jamesrklau/bead-chain-blind-motor/cad/case/case_lid.stl

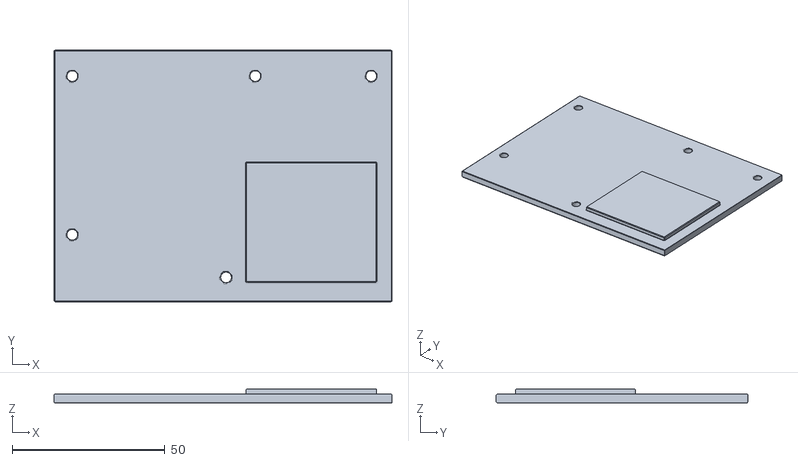
[picture p1: CAD file, 2026-11-08]
cad/case/case_lid.stl
110.8 x 82.5 x 4.70
