jamesrklau/bead-chain-blind-motor/cad/sprocket/bead_chain_sprocket_test_plate.stl

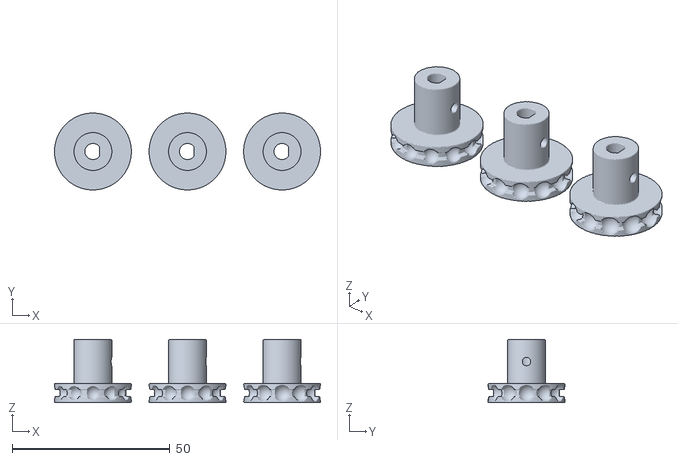
[picture p2: CAD file, 2026-11-08]
cad/sprocket/bead_chain_sprocket_test_plate.stl
84.4 x 24.4 x 20.0
