jamesrklau/bead-chain-blind-motor/(list of files, cad)

Other CAD files:
cad/case/case_body.stl
