jamesrklau/bead-chain-blind-motor/(commit log)

2026-11-08 Added 3D print files
    [bead_chain_sprocket_test_plate.stl, case_body.stl, case_lid.stl]
2026-11-09 Updated ReadME to reflect milestone completion and updated screenshots and motor video
    Updated links and status checkboxes in README.
